movray/antennas/moxon-868/moxon-868-etch-mirrored.pdf

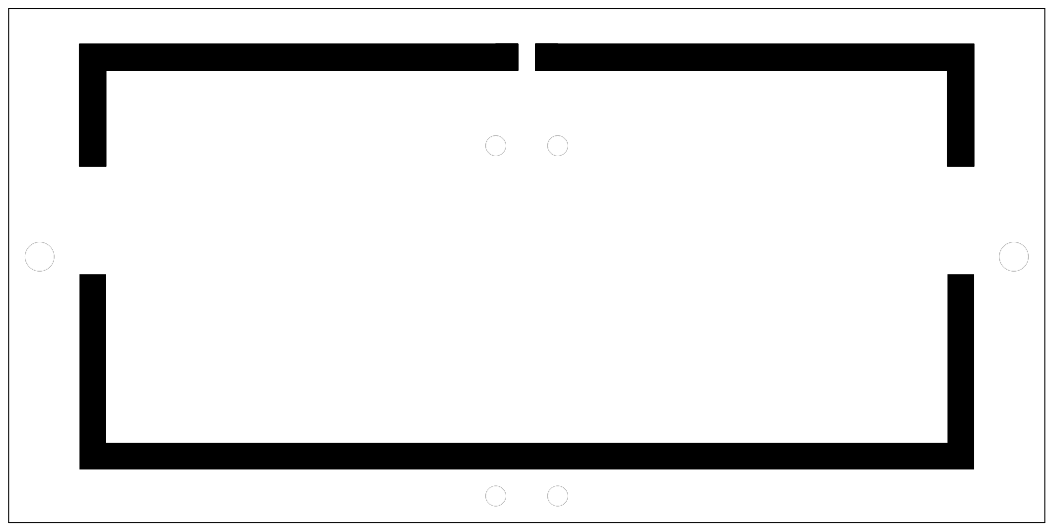
[picture p2: page 1]
