movray/antennas/moxon-868/moxon-868-etch-topview.pdf

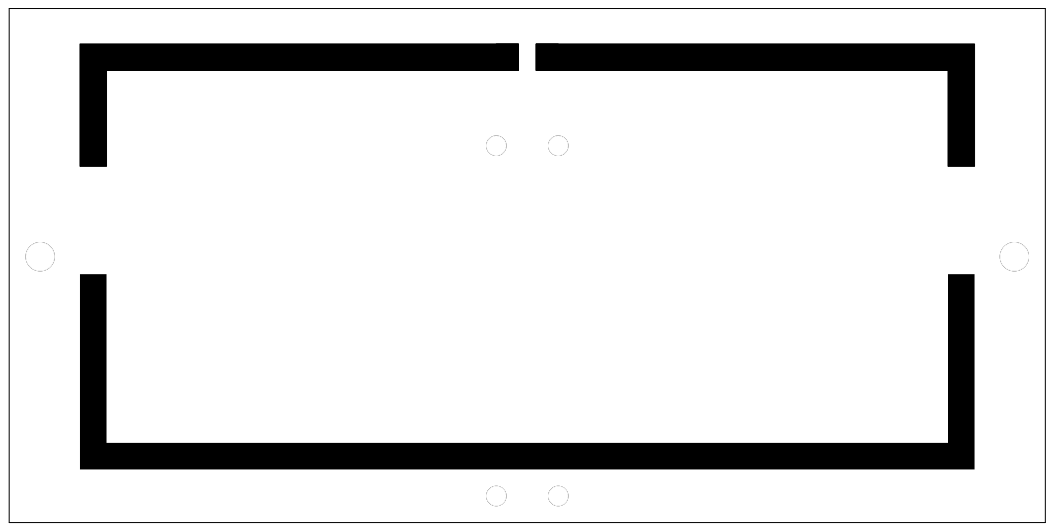
[picture p3: page 1]
