movray/antennas/moxon-868/moxon-868.kicad_pcb

## KiCad design moxon-868/moxon-868.kicad_pcb (2026-11-03)

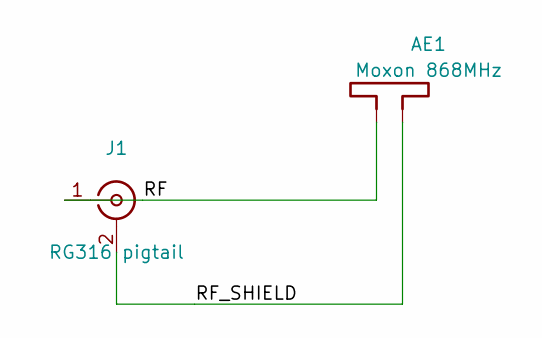
[picture p4: schematic moxon-868.kicad_sch, Moxon Antenna 868 MHz]

Parts:
AE1: Moxon 868MHz; Moxon_868
J1: RG316 pigtail; CoaxFeed_Gap2mm

Connections:
/RF: AE1.1, J1.1 (In)
/RF_SHIELD: AE1.2, J1.2 (Ext)

Board: 2 copper layers, 8 parts (0 on the bottom side), 2 nets, no tracks yet.

Other parts of the board:
H1, H2: MountingHole_3.2mm_M3
H3, H4, H5, H6: MountingHole_2.2mm_M2
